ChocolateBodywash/KOSMO_CatsSnare/Cats Snare Schematic.pdf

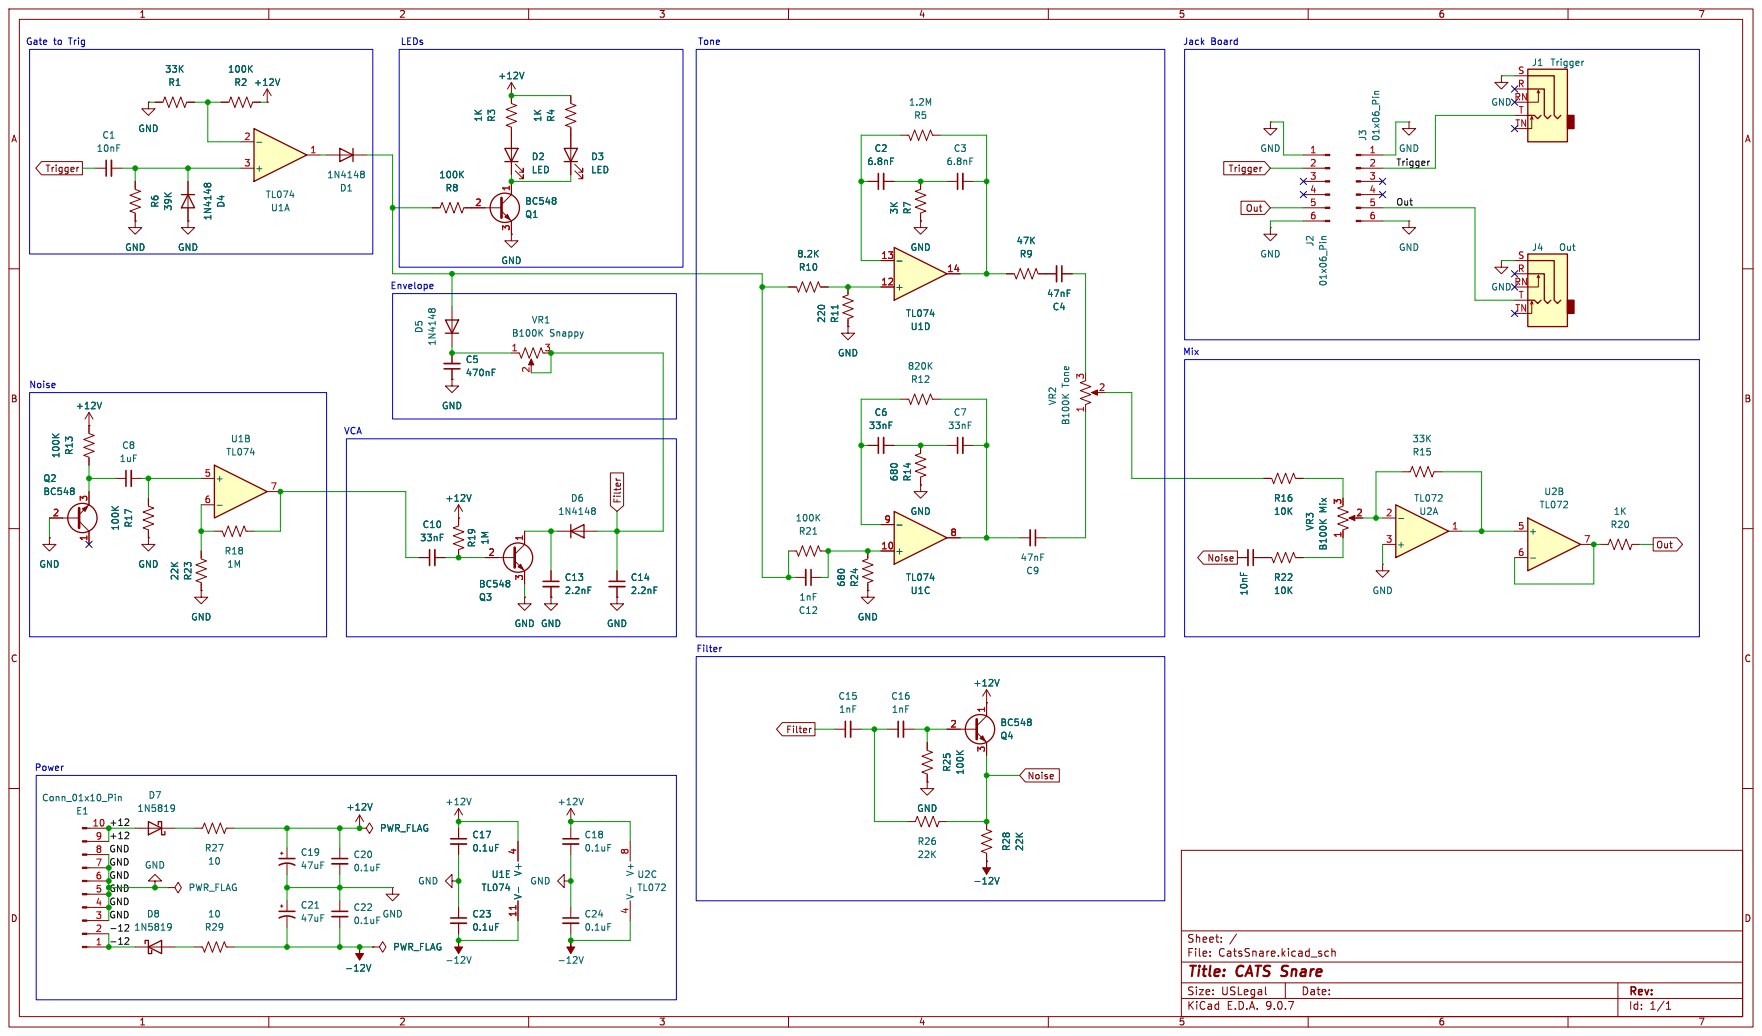
[picture p2: page 1]

Jack Board Mix VCA Noise Gate to Trig

Out Trigger Noise Filter Filter
LED

Id: 1/1 Title: CATS Snare
