ChocolateBodywash/KOSMO_CatsSnare/Main/CatsSnare.kicad_pcb

## KiCad design Main/CatsSnare.kicad_pcb (2026-10-14)

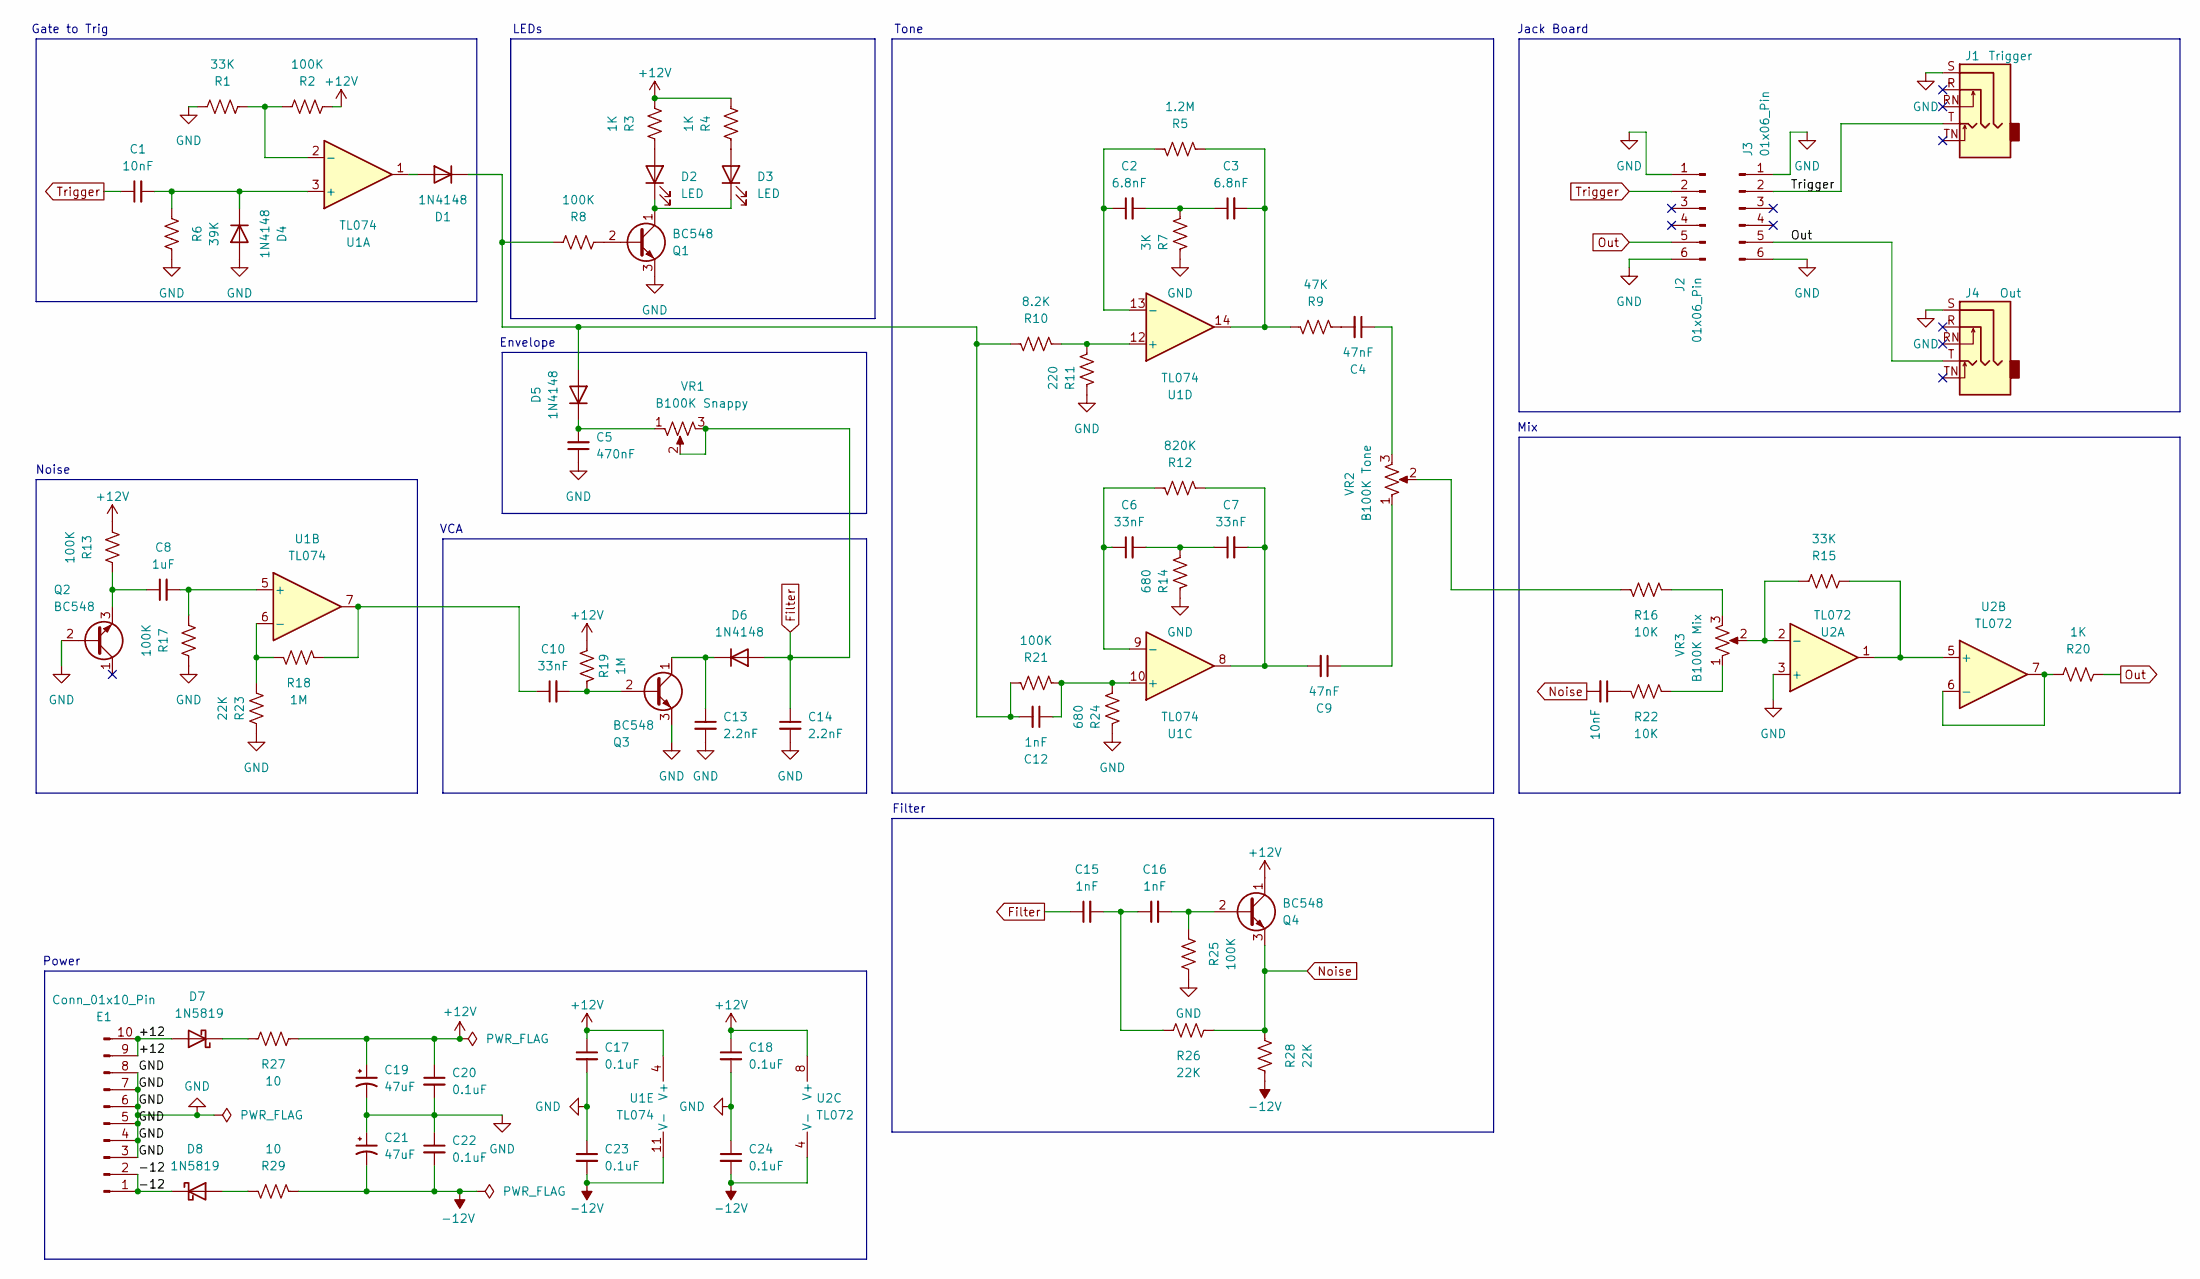
[picture p3: schematic CatsSnare.kicad_sch]

Parts:
C1, C11: 10nF; C_Rect_L7.0mm_W2.5mm_P5.00mm
C2, C3: 6.8nF; C_Rect_L7.0mm_W2.5mm_P5.00mm
C4, C9: 47nF; C_Rect_L7.0mm_W2.5mm_P5.00mm
C5: 470nF; C_Rect_L7.0mm_W2.5mm_P5.00mm
C6, C7, C10: 33nF; C_Rect_L7.0mm_W2.5mm_P5.00mm
C8: 1uF; C_Rect_L7.2mm_W5.5mm_P5.00mm_FKS2_FKP2_MKS2_MKP2
C12, C15, C16: 1nF; C_Rect_L7.0mm_W2.5mm_P5.00mm
C13, C14: 2.2nF; C_Rect_L7.0mm_W2.5mm_P5.00mm
C17, C18, C20, C22, C23, C24: 0.1uF; C_Disc_D3.0mm_W1.6mm_P2.50mm
C19, C21: 47uF; CP_Radial_D5.0mm_P2.50mm
D1, D4, D5, D6: 1N4148; D_DO-35_SOD27_P7.62mm_Horizontal
D2, D3: LED; LED_D5.0mm
D7, D8: 1N5819; D_DO-41_SOD81_P10.16mm_Horizontal
E1: Conn_01x10_Pin; Pins_2x05_2.54mm_TH_EurorackPower_Shrouded
J1: Trigger; Jack_6.35mm_PJ_629HAN
J2, J3: 01x06_Pin; PinHeader_1x06_P2.54mm_Vertical_Centered
J4: Out; Jack_6.35mm_PJ_629HAN
Q1, Q2, Q3, Q4: BC548; TO-92_Inline_Wide
R1, R15: 33K; R_Axial_DIN0207_L6.3mm_D2.5mm_P10.16mm_Horizontal
R2, R8, R13, R17, R21, R25: 100K; R_Axial_DIN0207_L6.3mm_D2.5mm_P10.16mm_Horizontal
R3, R4, R20: 1K; R_Axial_DIN0207_L6.3mm_D2.5mm_P10.16mm_Horizontal
R5: 1.2M; R_Axial_DIN0207_L6.3mm_D2.5mm_P10.16mm_Horizontal
R6: 39K; R_Axial_DIN0207_L6.3mm_D2.5mm_P10.16mm_Horizontal
R7: 3K; R_Axial_DIN0207_L6.3mm_D2.5mm_P10.16mm_Horizontal
R9: 47K; R_Axial_DIN0207_L6.3mm_D2.5mm_P10.16mm_Horizontal
R10: 8.2K; R_Axial_DIN0207_L6.3mm_D2.5mm_P10.16mm_Horizontal
R11: 220; R_Axial_DIN0207_L6.3mm_D2.5mm_P10.16mm_Horizontal
R12: 820K; R_Axial_DIN0207_L6.3mm_D2.5mm_P10.16mm_Horizontal
R14, R24: 680; R_Axial_DIN0207_L6.3mm_D2.5mm_P10.16mm_Horizontal
R16, R22: 10K; R_Axial_DIN0207_L6.3mm_D2.5mm_P10.16mm_Horizontal
R18, R19: 1M; R_Axial_DIN0207_L6.3mm_D2.5mm_P10.16mm_Horizontal
R23, R26, R28: 22K; R_Axial_DIN0207_L6.3mm_D2.5mm_P10.16mm_Horizontal
R27, R29: 10; R_Axial_DIN0207_L6.3mm_D2.5mm_P10.16mm_Horizontal
U1: TL074; DIP-14_W7.62mm_Socket_LongPads
U2: TL072; DIP-8_W7.62mm_Socket_LongPads
VR1: B100K Snappy; Potentiometer_Alpha_RD901F-40-00D_Single_Vertical
VR2: B100K Tone; Potentiometer_Alpha_RD901F-40-00D_Single_Vertical
VR3: B100K Mix; Potentiometer_Alpha_RD901F-40-00D_Single_Vertical

Connections:
+12V: C17.1, C18.1, C19.1, C20.1, Q4.1 (C), R2.1, R3.1, R4.1, R13.1, R19.1, R27.2, U1.4 (V+), U2.8 (V+)
-12V: C21.2, C22.2, C23.2, C24.2, R28.1, R29.2, U1.11 (V-), U2.4 (V-)
/+12: D7.2 (A), E1.9, E1.10
/-12: D8.1 (K), E1.1, E1.2
Filter: C14.1, C15.1, D6.2 (A), VR1.2, VR1.3
GND: C5.1, C13.2, C14.2, C17.2, C18.2, C19.2, C20.2, C21.1, C22.1, C23.1, C24.1, D4.2 (A), E1.3, E1.4, E1.5, E1.6, E1.7, E1.8, J1.S, J2.1, J2.6, J3.1, J3.6, J4.S, Q1.3 (E), Q2.2 (B), Q3.3 (E), R1.2, R6.1, R7.1, R11.1, R14.1, R17.2, R23.2, R24.1, R25.1, U2.3 (+)
unnamed: C2.2, C3.1, R7.2
unnamed: C3.2, R5.2, R9.1, U1.14
unnamed: C4.1, VR2.3
unnamed: C4.2, R9.2
unnamed: C6.2, C7.1, R14.2
unnamed: C7.2, C9.2, R12.2, U1.8
unnamed: C9.1, VR2.1
unnamed: C10.1, R18.1, U1.7
unnamed: C11.1, R22.2
unnamed: C15.2, C16.1, R26.1
unnamed: D1.2 (A), U1.1
unnamed: C12.2, D1.1 (K), D5.2 (A), R8.2, R10.1, R21.1
unnamed: D2.2 (A), R3.2
unnamed: D2.1 (K), D3.1 (K), Q1.1 (C)
unnamed: D3.2 (A), R4.2
unnamed: C1.2, D4.1 (K), R6.2, U1.3 (+)
unnamed: C5.2, D5.1 (K), VR1.1
unnamed: C13.1, D6.1 (K), Q3.1 (C)
unnamed: D7.1 (K), R27.1
unnamed: D8.2 (A), R29.1
unnamed: Q1.2 (B), R8.1
unnamed: C8.1, Q2.3 (E), R13.2
unnamed: C10.2, Q3.2 (B), R19.2
unnamed: C16.2, Q4.2 (B), R25.2
unnamed: R16.1, VR3.3
unnamed: R16.2, VR2.2
unnamed: R22.1, VR3.1
unnamed: R1.1, R2.2, U1.2 (-)
unnamed: C8.2, R17.1, U1.5 (+)
unnamed: R18.2, R23.1, U1.6 (-)
unnamed: C12.1, R21.2, R24.2, U1.10 (+)
unnamed: C6.1, R12.1, U1.9 (-)
unnamed: R10.2, R11.2, U1.12 (+)
unnamed: C2.1, R5.1, U1.13 (-)
unnamed: R15.2, U2.2 (-), VR3.2
unnamed: R15.1, U2.1, U2.5 (+)
unnamed: R20.2, U2.6 (-), U2.7
Noise: C11.2, Q4.3 (E), R26.2, R28.2
Out: J2.5, J3.5, J4.T, R20.1
Trigger: C1.1, J1.T, J2.2, J3.2

Notes on the sheet:
VCA
Filter
Power
Gate to Trig
Noise
Tone
LEDs
Envelope
Jack Board
Mix

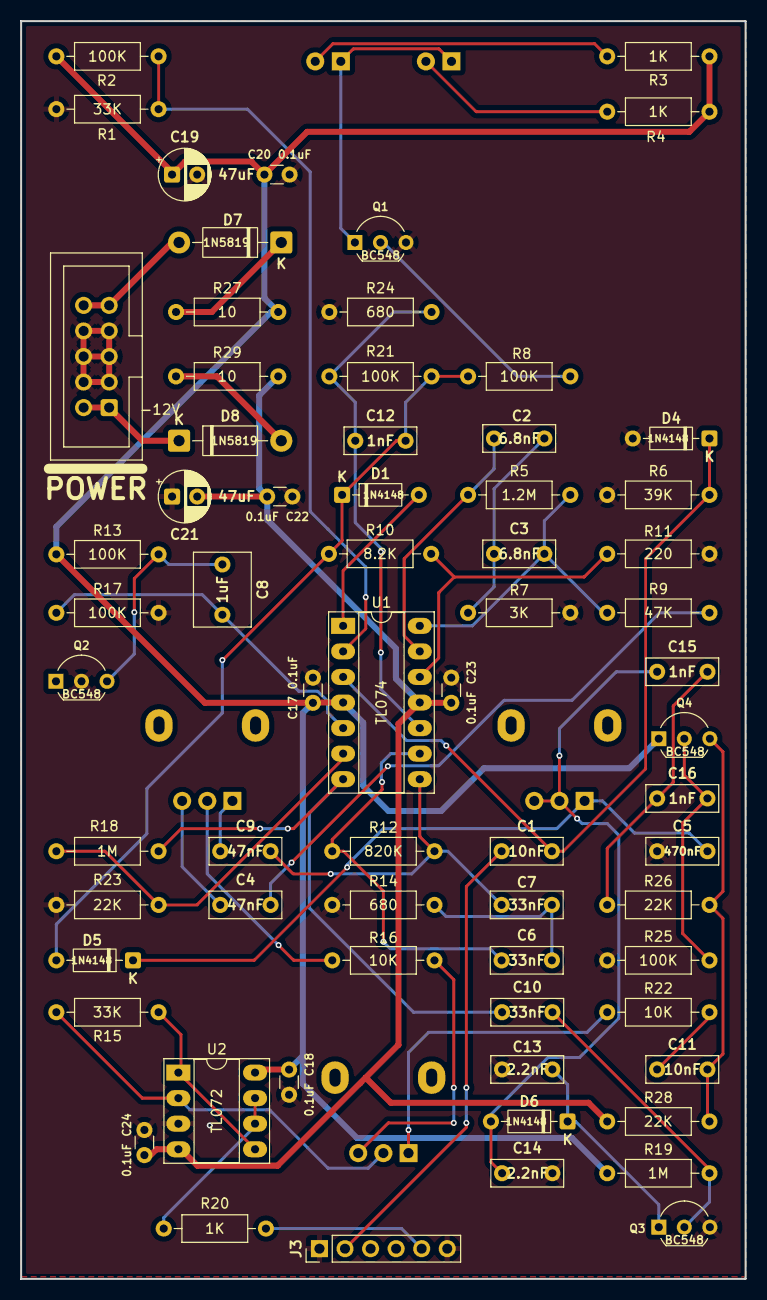
[picture p4: board CatsSnare.kicad_pcb from above]

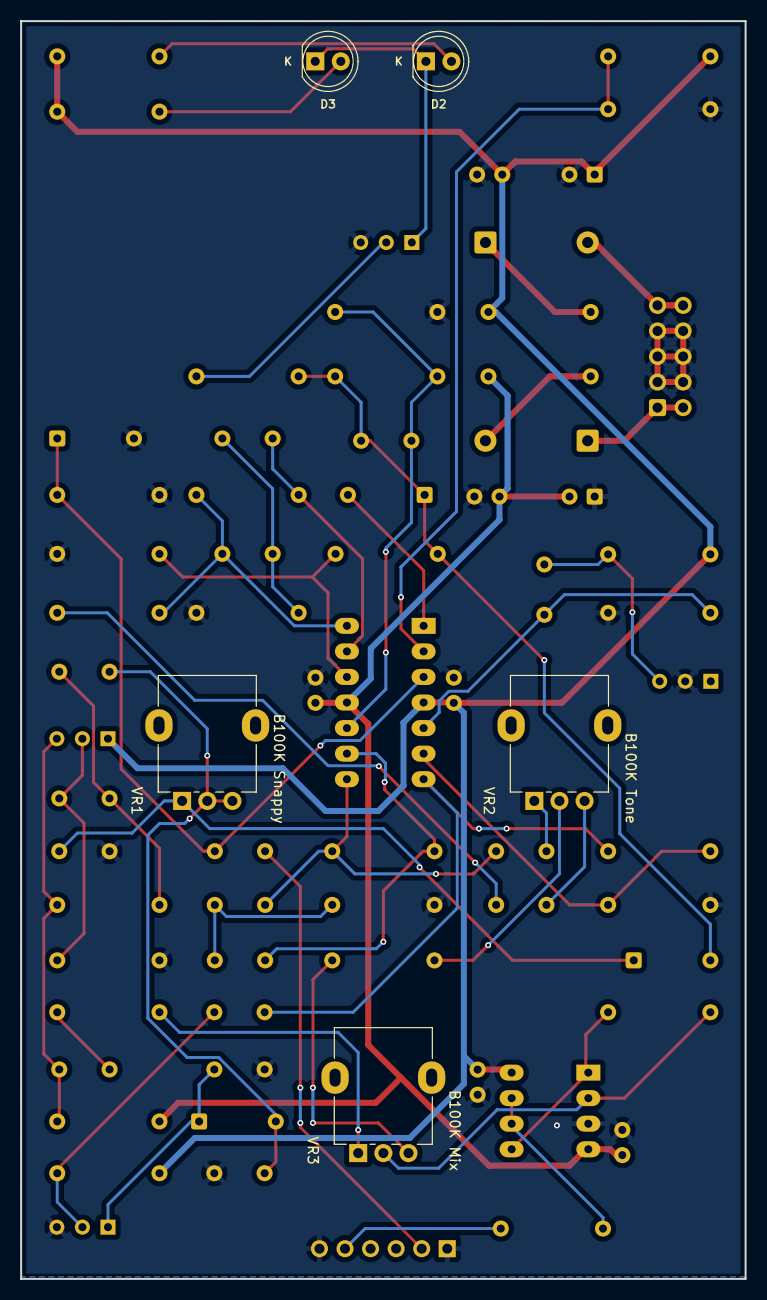
[picture p5: board CatsSnare.kicad_pcb from below]

Board: 2 copper layers, 72.0 x 125.0 mm, 72 parts (5 on the bottom side), 46 nets.
